romioRN/Dash6.8-hardware/pinout.jpg

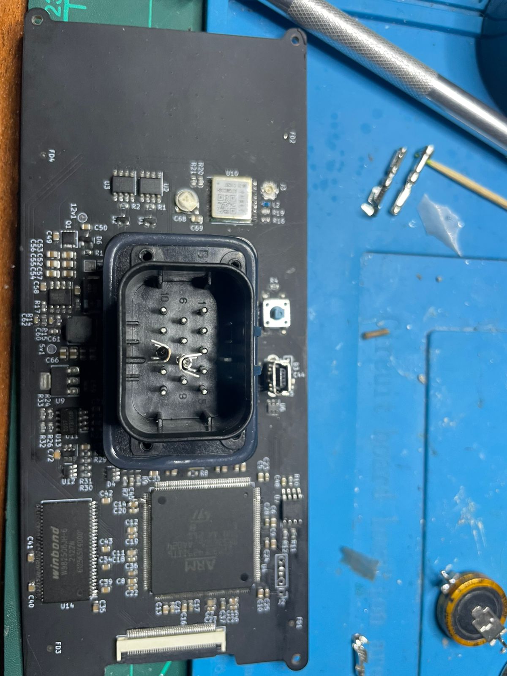
pinout.jpg
