romioRN/Dash6.8-hardware/photos/Dash 6.8.6.jpg

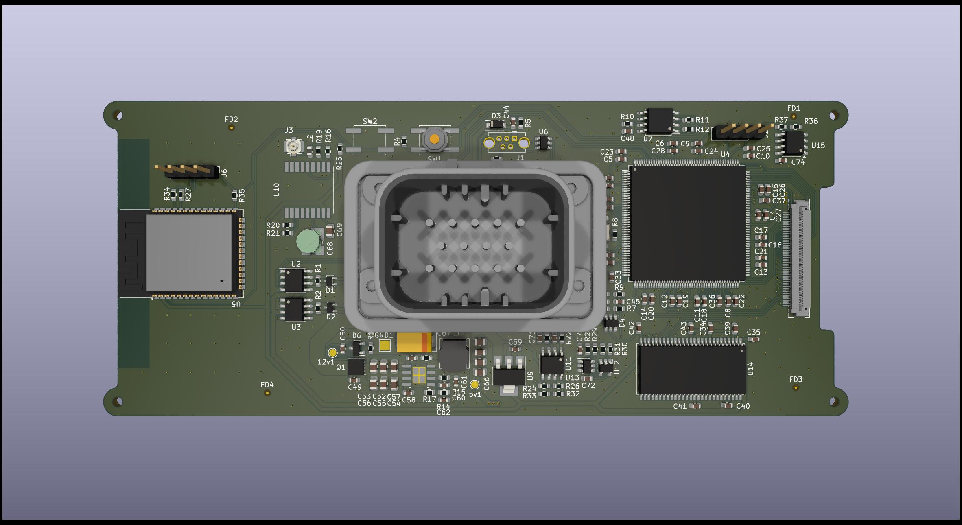
photos/Dash 6.8.6.jpg
