romioRN/Dash6.8-hardware/readme.md

stm32f4

8MB RAM

flash

ESP32 S3 wifi calibration page

ATGM336H GPS with on-board battery

wifi name "service", password 12345678, connect to 192.167.4.1

2 layer PCB

single side assembly

nextPCB

# hardware

* GPS antenna 5v "GPS Antenna SMA Connector Car Mini GPS Receiver Antenna 3 Meters Cable Car GPS Antenna Receiver for Car Navigation Camera Player"

* Пигтейл SMA female - MHF4 адаптер переходник для подключения внешней антенны Best Seller

* ribbon cable FFC FPC 40 pin,Reverse Direction,5cm 0.5mm

* threaded inserts M2xL4xOD3.2

* m2 din912 

# pinout

* pin 6 CANH

* pin 8 GND

* 10 CANL

* pin 12 12v

# Firmware

https://github.com/romioRN/Dash6.8-firmware

precompiled F4 binaries at https://github.com/romioRN/Dash6.8-firmware/tree/main/Firmware/Debug
корпус литье в силикон
корпус литье в силикон 2
