romioRN/Dash6.8-hardware/docs/readme.md

https://www.aliexpress.us/item/3256804554532347.html
перед2
зад2
раз
