romioRN/Dash6.8-hardware/enclosure/enclosure-v1/readme.md

As is, this design would not accept bronze threaded inserts
