romioRN/Dash6.8-hardware/docs/6-86.jpg

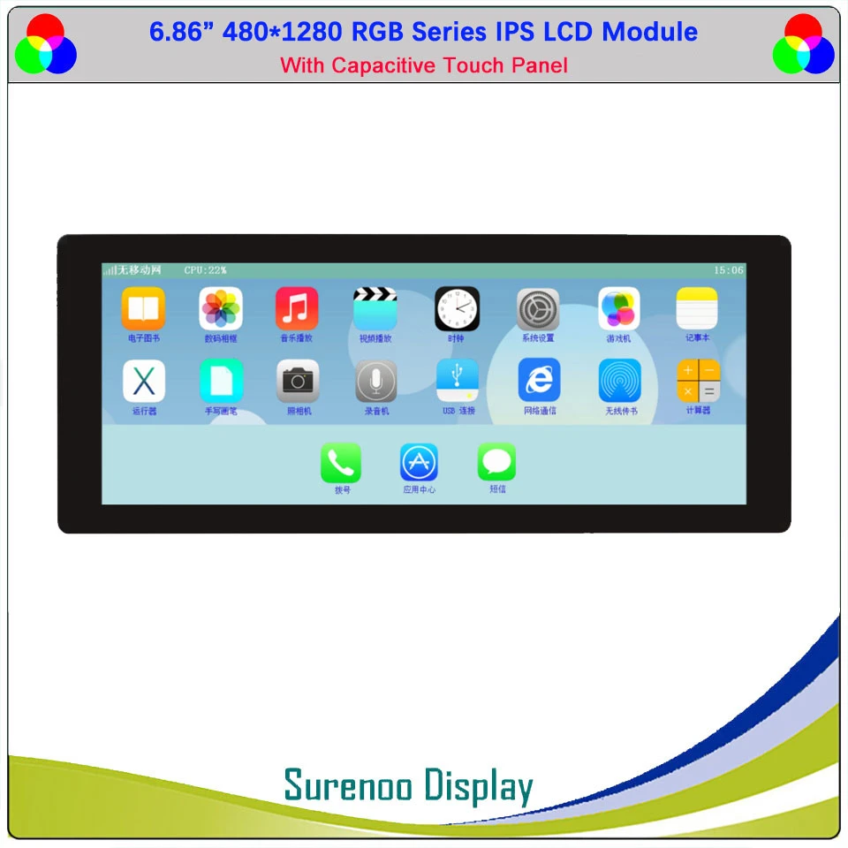
docs/6-86.jpg
