romioRN/Dash6.8-hardware/docs/S1af3b5e822c3414c8dfa9511a9d78017A.jpg

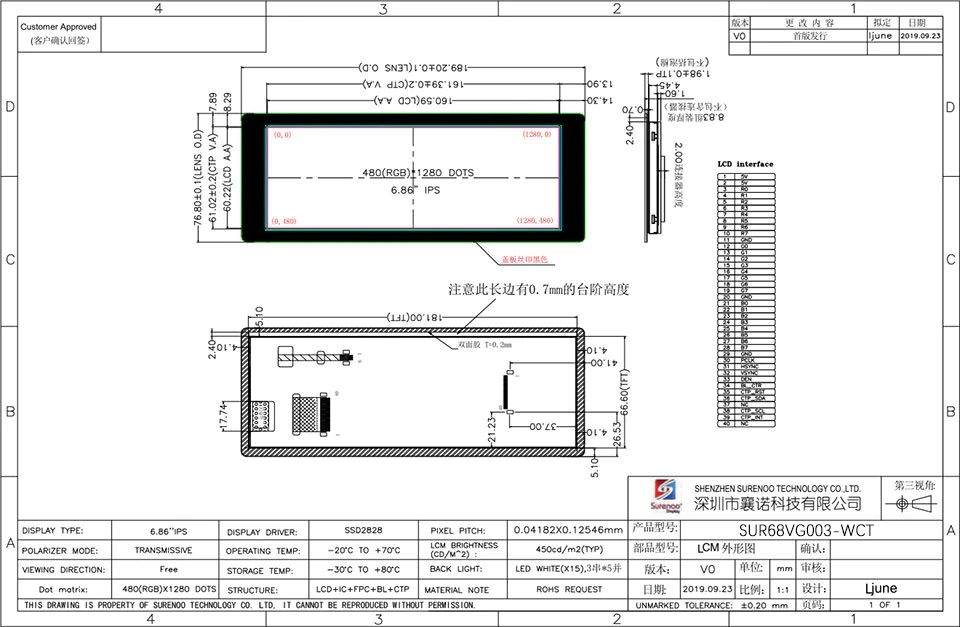
docs/S1af3b5e822c3414c8dfa9511a9d78017A.jpg
