romioRN/Dash6.8-hardware/image/DugaF.png

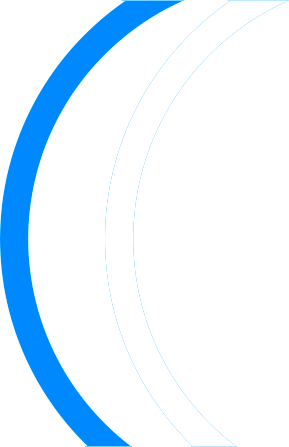
image/DugaF.png
