romioRN/Dash6.8-hardware/image/Fon1.png

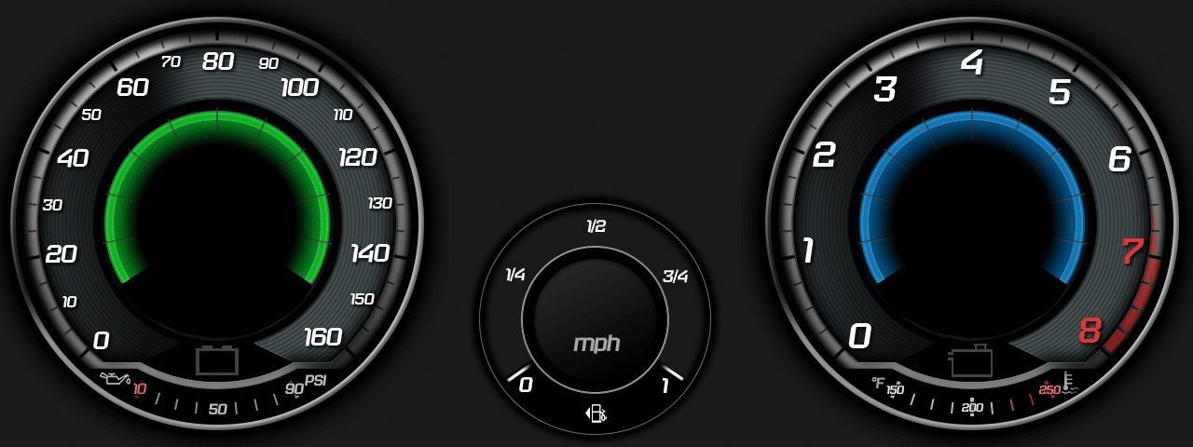
image/Fon1.png
