romioRN/Dash6.8-hardware/image/race_dash_wide.png

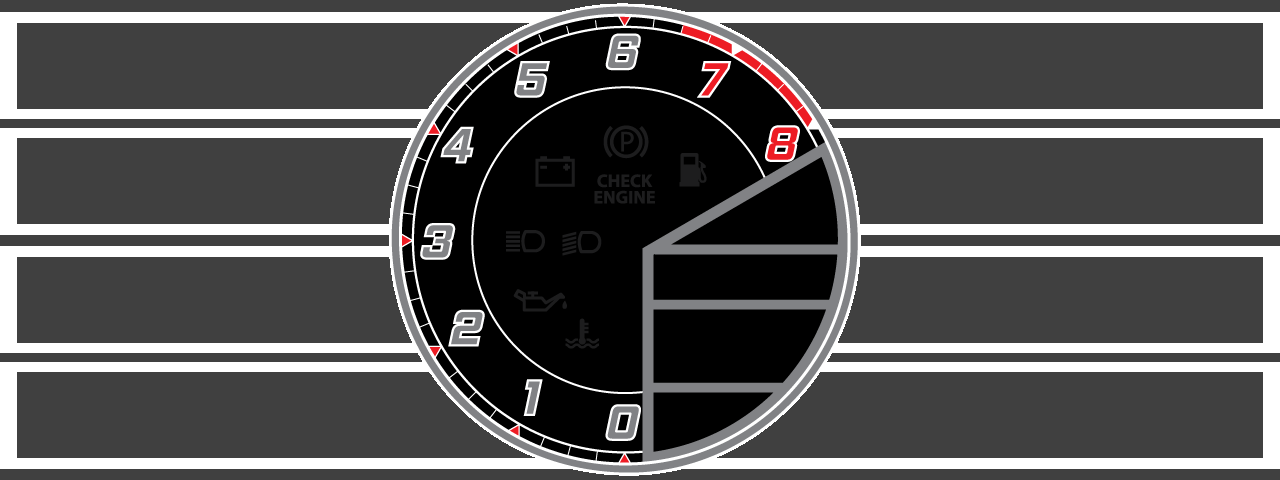
image/race_dash_wide.png
