romioRN/Dash6.8-hardware/image/ST800_2.png

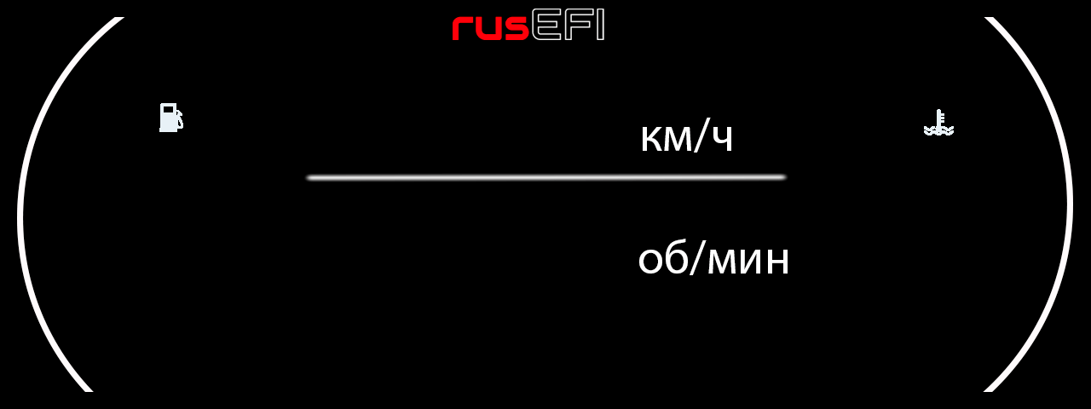
image/ST800_2.png
