romioRN/Dash6.8-hardware/image/ST800_3.png

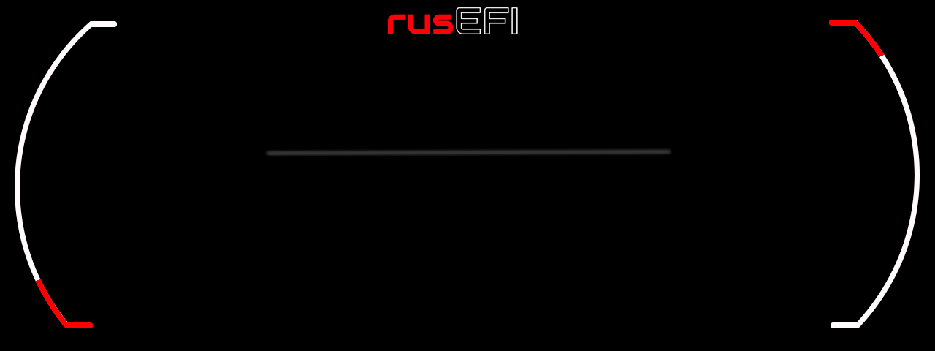
image/ST800_3.png
