romioRN/Dash6.8-hardware/image/ST800_4.png

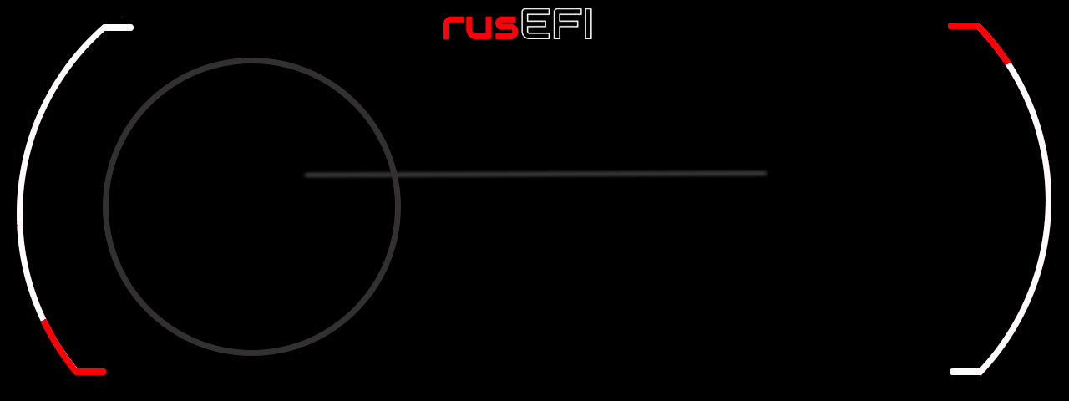
image/ST800_4.png
