romioRN/Dash6.8-hardware/image/ST800_5.png

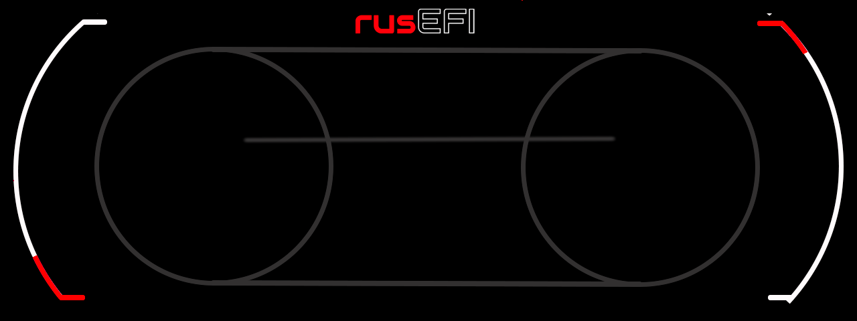
image/ST800_5.png
