romioRN/Dash6.8-hardware/image/ST800_6.png

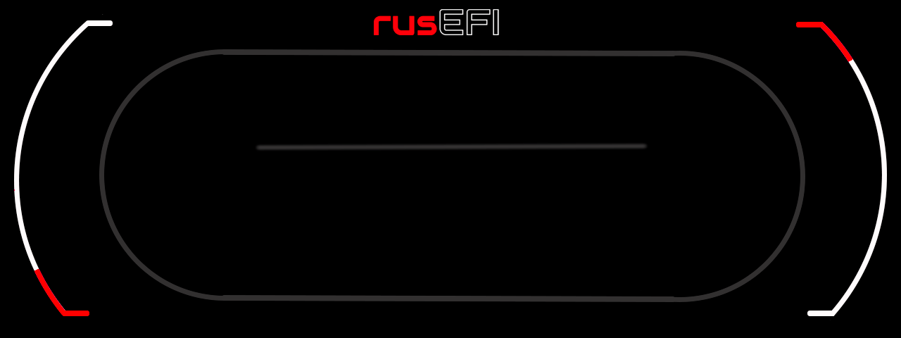
image/ST800_6.png
