romioRN/Dash6.8-hardware/image/ST800_7.png

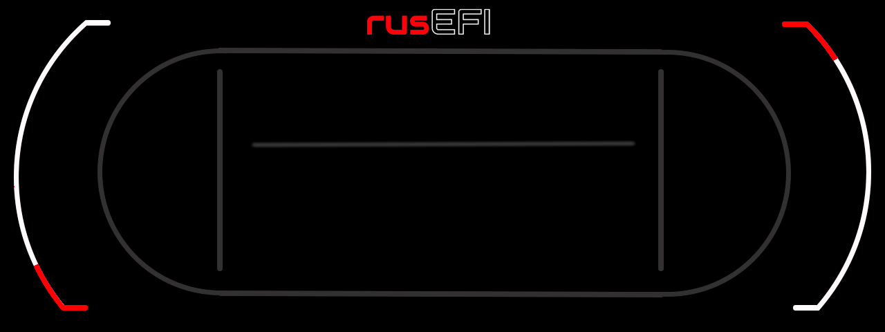
image/ST800_7.png
