romioRN/Dash6.8-hardware/image/ST800_8.png

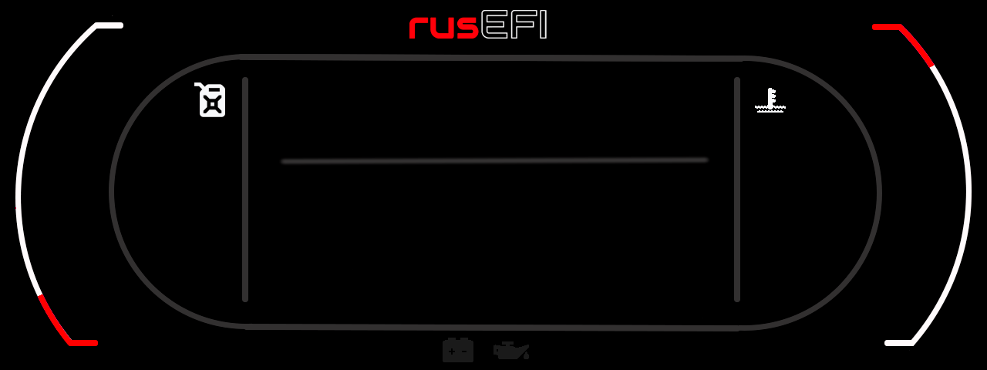
image/ST800_8.png
