romioRN/Dash6.8-hardware/image/приборы стелс800.png

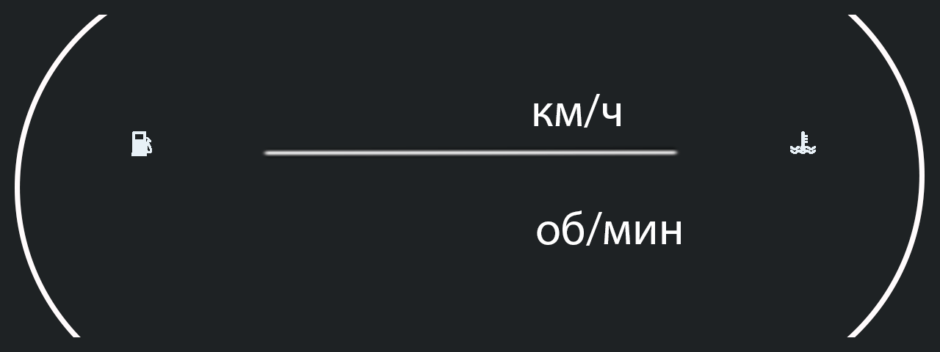
image/приборы стелс800.png
