romioRN/Dash6.8-hardware/image/приборы стелс800_1.png

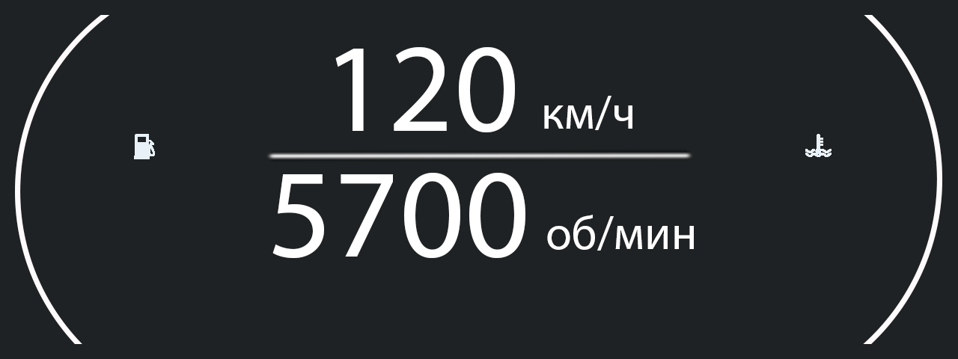
image/приборы стелс800_1.png
