romioRN/Dash6.8-hardware/photos/Dash 6.8.7.jpg

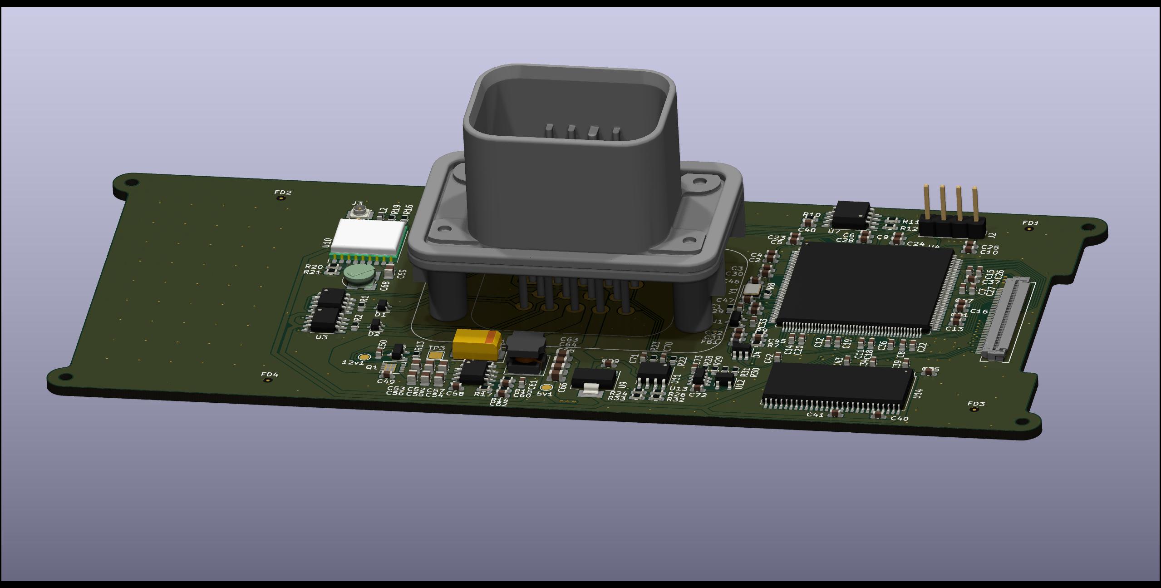
photos/Dash 6.8.7.jpg
