romioRN/Dash6.8-hardware/photos/Dash 6.8.8.jpg

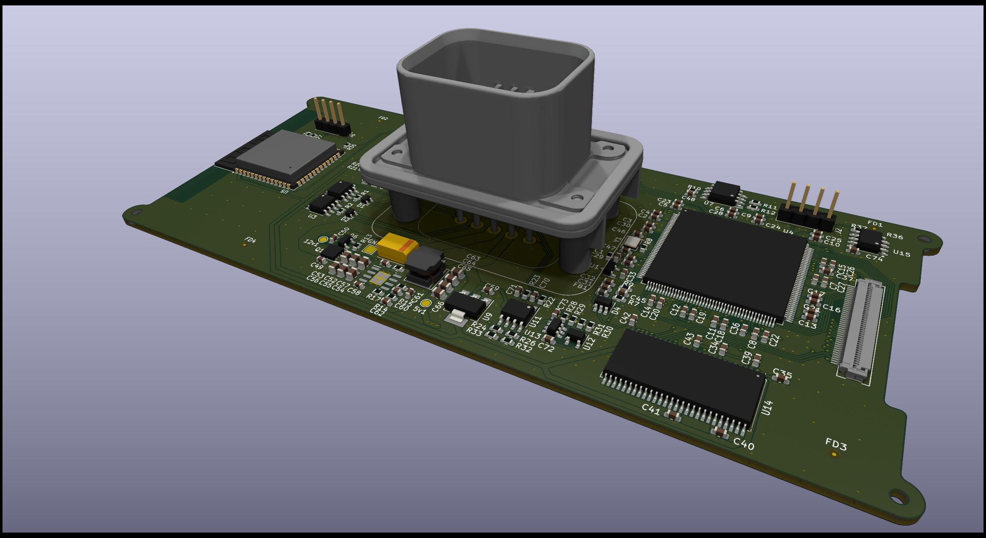
photos/Dash 6.8.8.jpg
