romioRN/Dash6.8-hardware/3d model/silicone casting/Dach_lcd6.89.SLDPRT

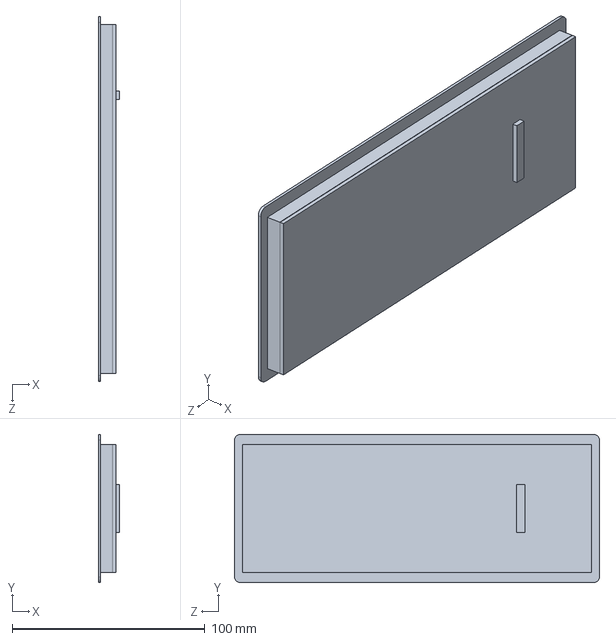
[picture p19: CAD file, 2024-11-07]
3d model/silicone casting/Dach_lcd6.89.SLDPRT
11.0 x 76.8 x 189.2 mm
