romioRN/Dash6.8-hardware/enclosure/enclosure-v1/cover_v1_1.STEP

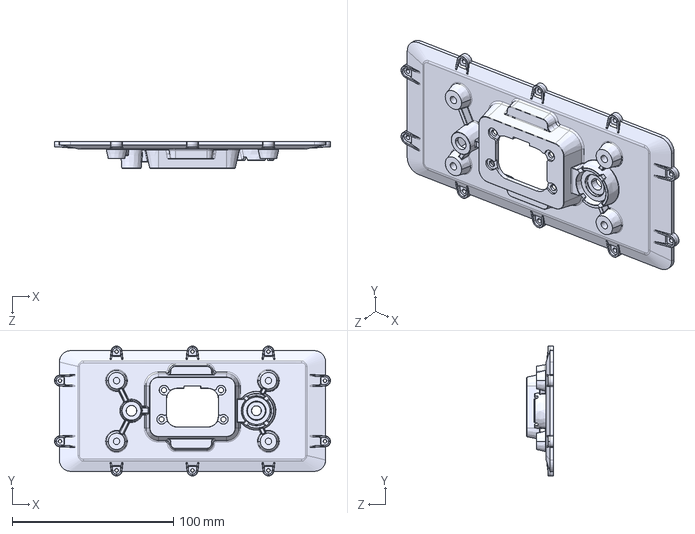
[picture p20: CAD file, 2025-10-01]
enclosure/enclosure-v1/cover_v1_1.STEP
170.9 x 80.4 x 16.5 mm
