romioRN/Dash6.8-hardware/enclosure/enclosure-v1/frame_v1.STEP

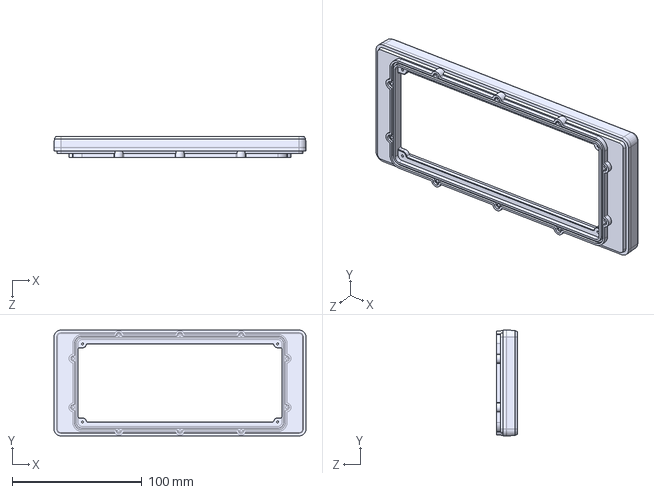
[picture p21: CAD file, 2025-06-23]
enclosure/enclosure-v1/frame_v1.STEP
194.0 x 81.5 x 16.0 mm
