romioRN/Dash6.8-hardware/Dash 6.8_V0.2/776262-1/776262-1.step

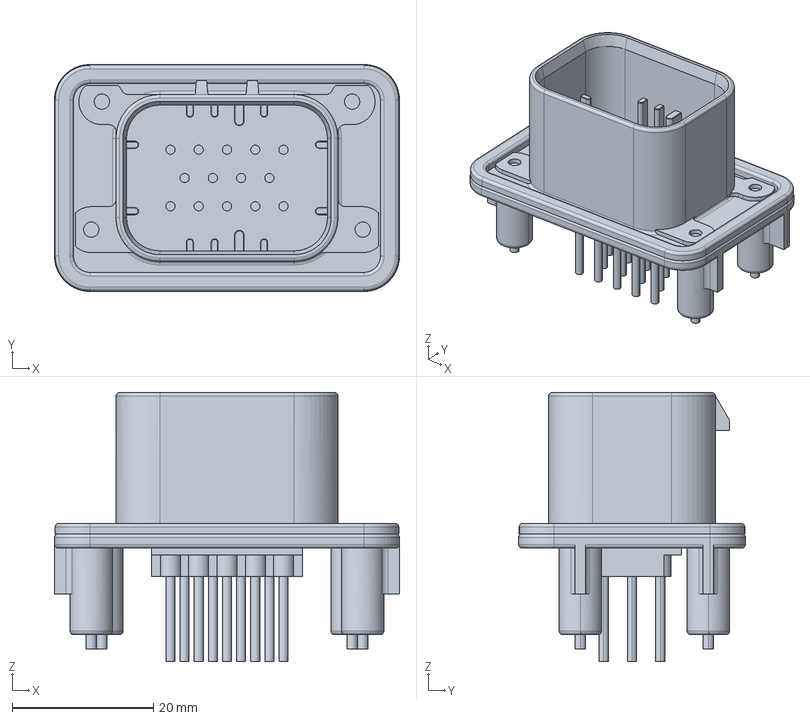
[picture p22: CAD file, 2025-06-23]
Dash 6.8_V0.2/776262-1/776262-1.step
48.8 x 32.1 x 38.1 mm
