romioRN/Dash6.8-hardware/changelog.md

# 0.2

known issue: https://github.com/romioRN/Dash_6.8-hardware/issues/2

still dreaming about H7 - no official H7 configuration

# 0.1

Alive using F429!

Not pin compatible with https://github.com/opelpanfan/car-dash-wide
