romioRN/Dash6.8-hardware/3d model/silicone casting/корпус литье в силикон.pdf

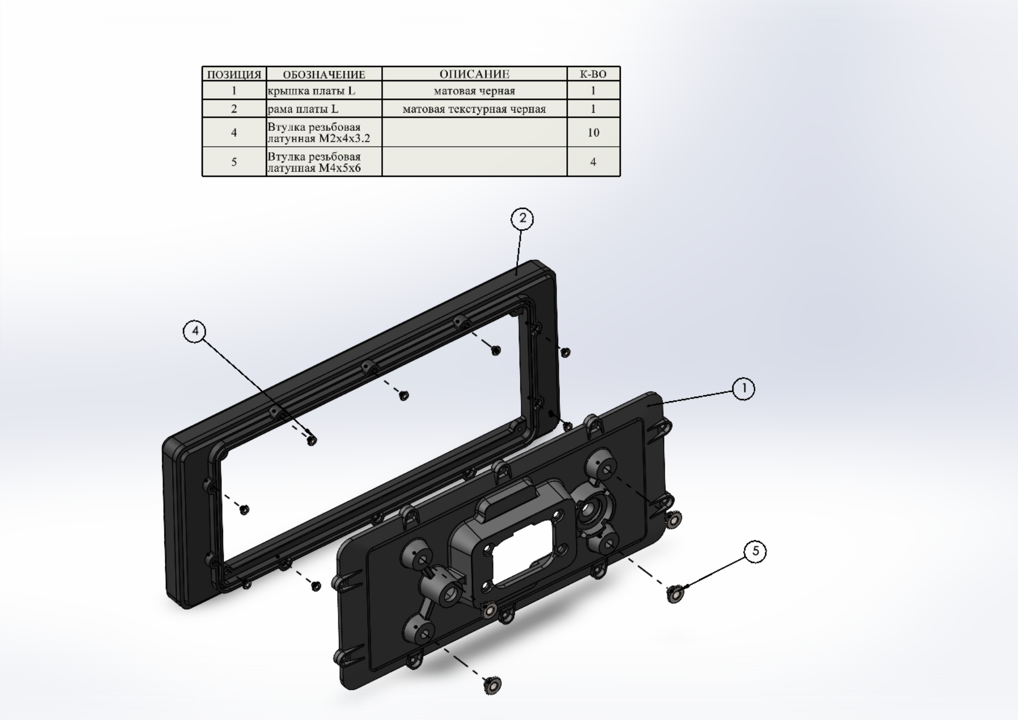
[picture p23: page 1]
