romioRN/Dash6.8-hardware/Dash 6.8_V0.2/Dash 6.8.kicad_pcb

## KiCad design Dash 6.8_V0.2/Dash 6.8.kicad_pcb (2025-09-16)

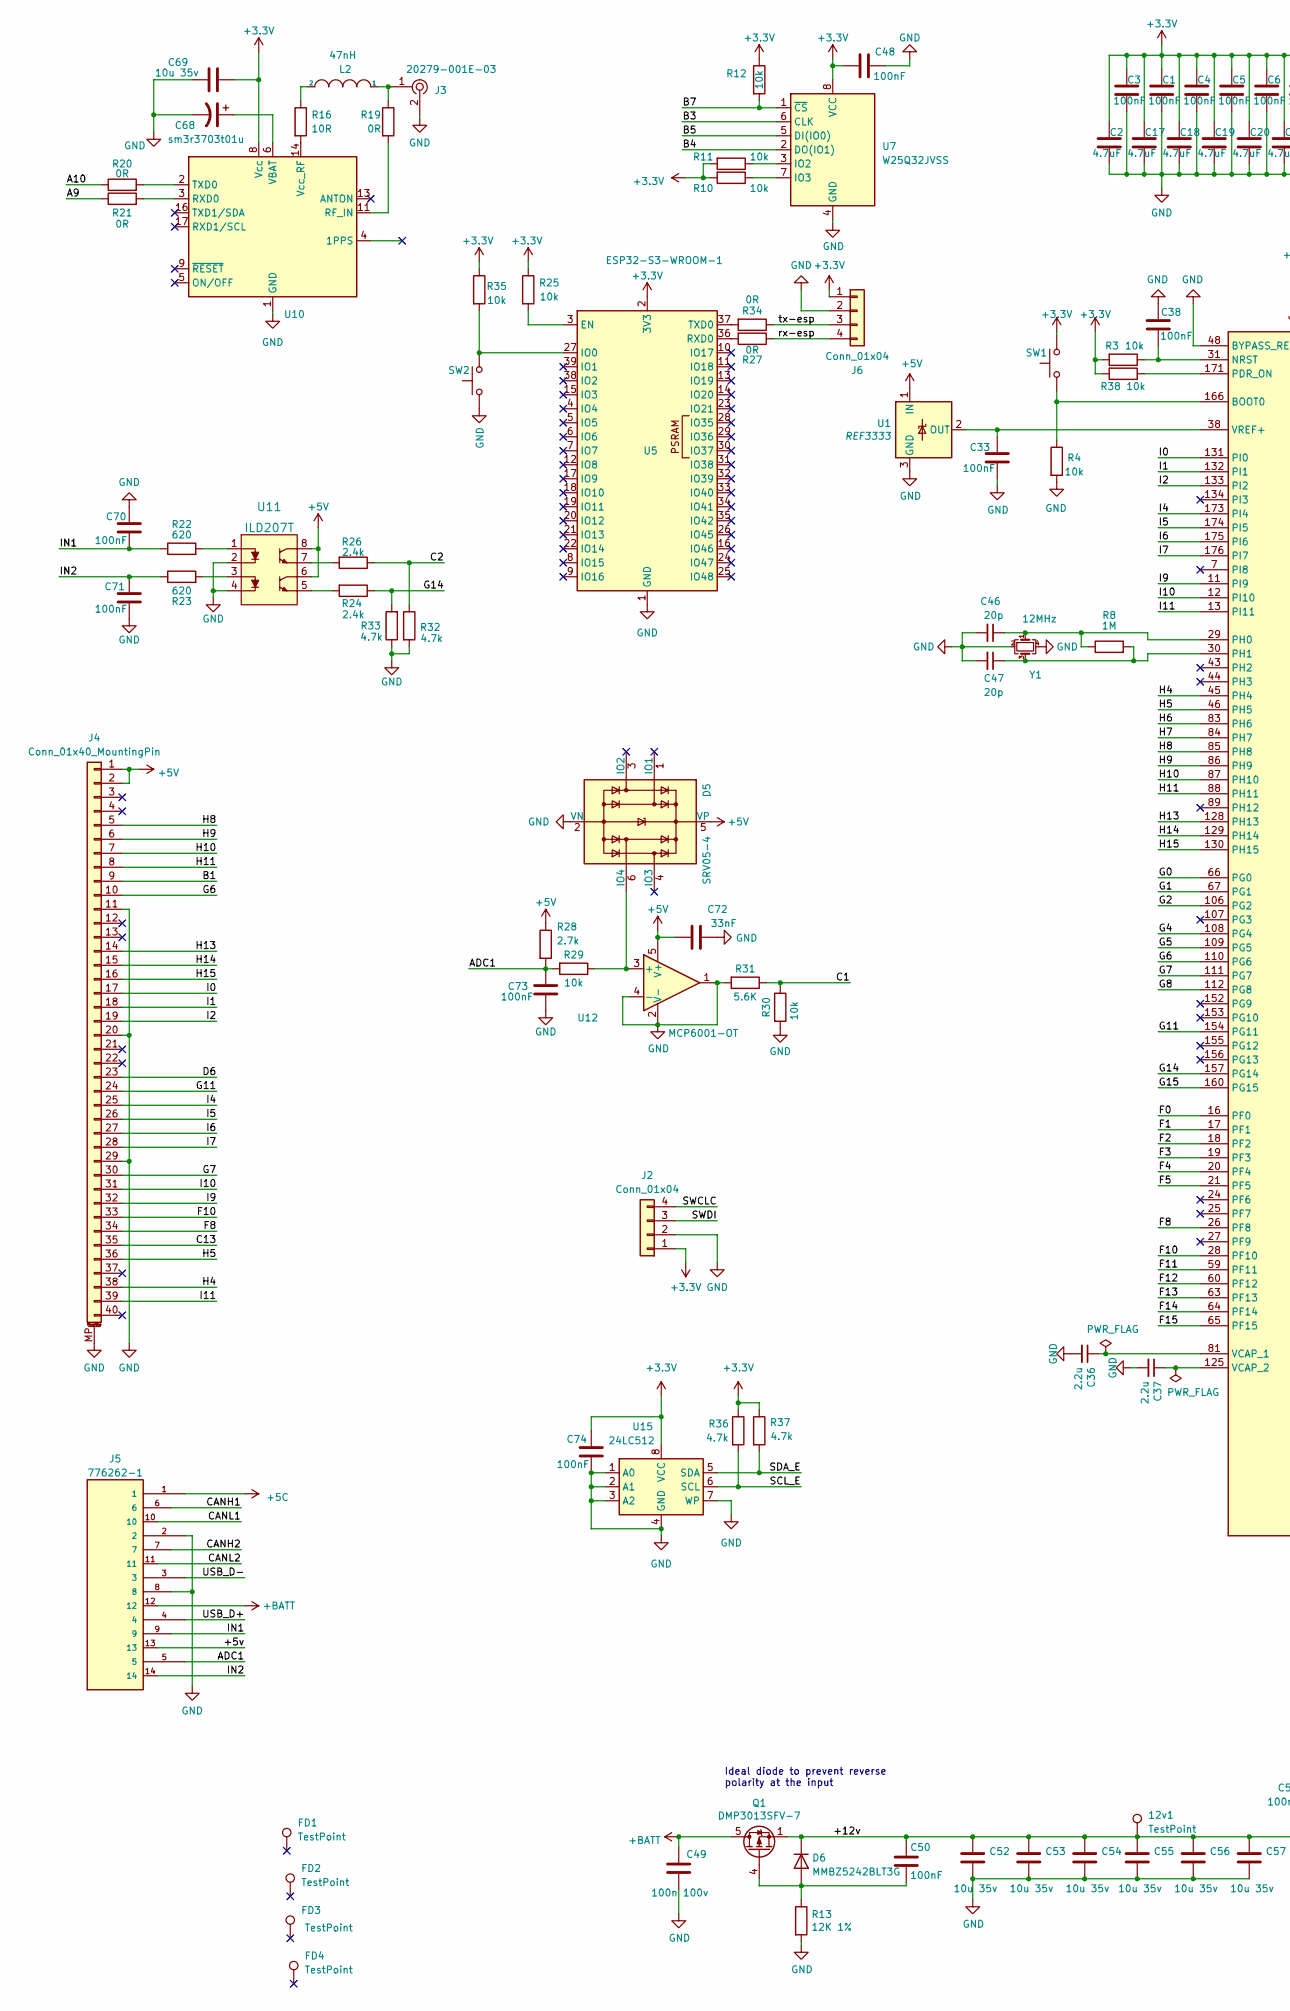
[picture p24: schematic Dash 6.8.kicad_sch, part in row 1, column 1]

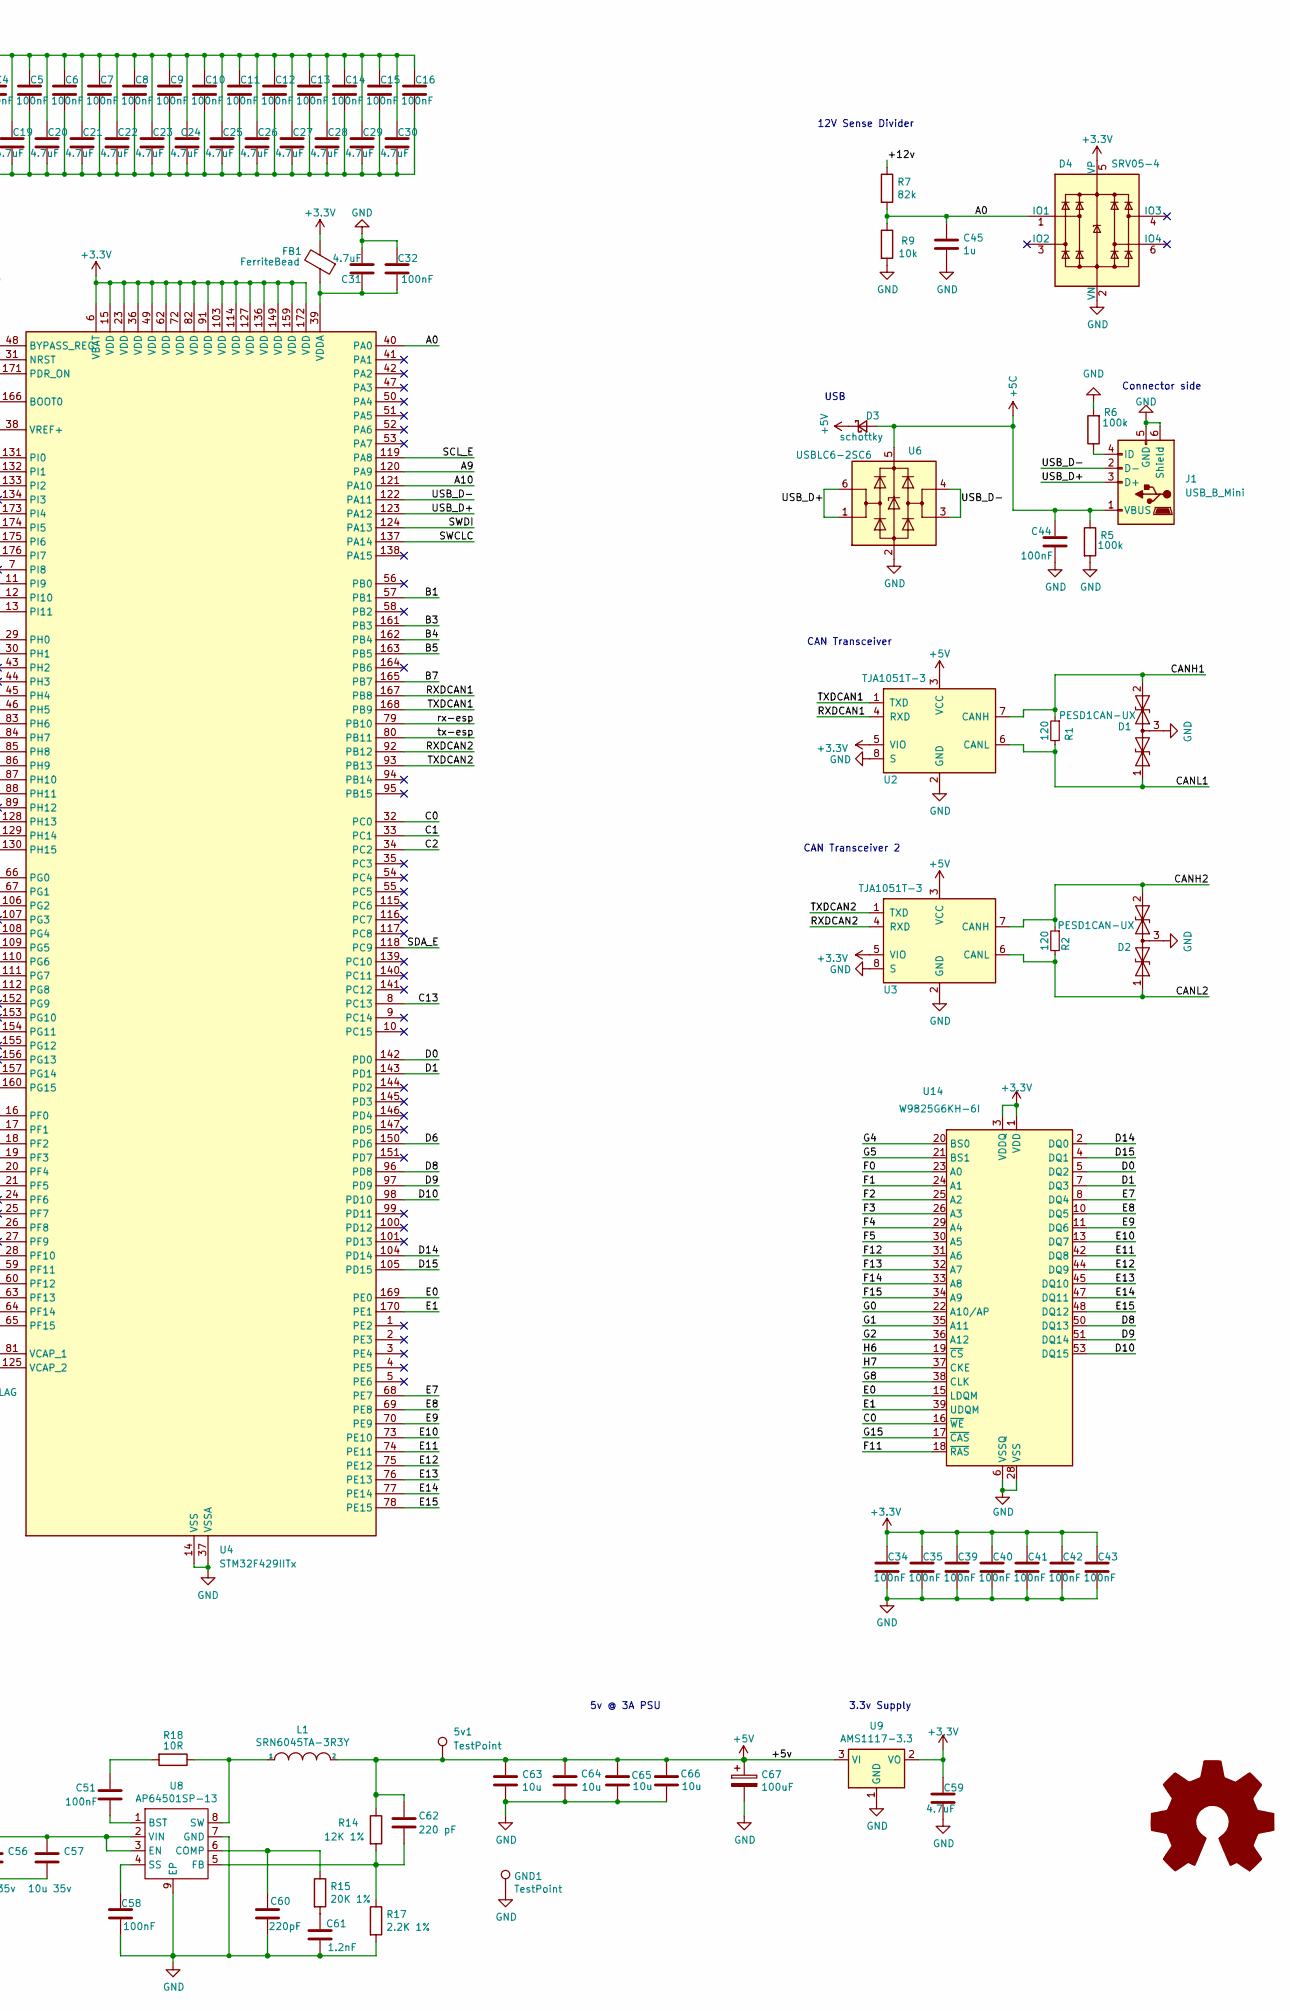
[picture p25: schematic Dash 6.8.kicad_sch, part in row 1, column 2]

Parts:
5v1, 12v1: TestPoint; TestPoint_Pad_D1.5mm
C1, C3, C4, C5, C6, C7, C8, C9, C10, C11, C12, C13, C14, C15, C16, C32, C33, C34, C35, C38, C39, C40, C41, C42, C43, C44, C48, C50, C51, C58, C70, C71, C73, C74: 100nF; C_0603_1608Metric; Part CC0603KRX7R9BB104
C2, C17, C18, C19, C20, C21, C22, C23, C24, C25, C26, C27, C28, C29, C30, C31, C59: 4.7uF; C_0603_1608Metric; Part CL10A475KO8NNNC
C36, C37: 2.2u; C_0603_1608Metric; Part CL10A225KO8NNNC; LCSC C23630
C45: 1u; C_0603_1608Metric; Part CL10A105KB8NNNC; LCSC C15849
C46, C47: 20p; C_0603_1608Metric; Part GRM1885C1H200JA01D
C49: 100n 100v; C_0603_1608Metric; Part CC0603KRX7R0BB104
C52, C53, C54, C55, C56, C57, C69: 10u 35v; C_0805_2012Metric; Part GRM21BC8YA106KE11L
C60: 220pF; C_0603_1608Metric; Part CC0603KRX7R0BB221
C61: 1.2nF; C_0603_1608Metric; Part CC0603KRX7R9BB122
C62: 220 pF; C_0603_1608Metric; Part CC0603KRX7R0BB221
C63, C64, C65, C66: 10u; C_0805_2012Metric; Part GRM21BR71A106KA73L
C67: 100uF; CP_EIA-7343-31_Kemet-D; Part 667-EEF-CX0J101R
C68: sm3r3703t01u; SM3R3703T01U; Part sm3r3703t01u
C72: 33nF; C_0603_1608Metric; Part CL10B333KB8NNNC
D1, D2: PESD1CAN-UX; SOT-323_SC-70; Part PESD1CAN-UX; LCSC C152727
D3: schottky; D_SOD-123; Part B5819W SL; LCSC C8598
D4, D5: SRV05-4; SOT-23-6; Part SRV05-4-P-T7; LCSC C85364
D6: MMBZ5242BLT3G; SOT-23; Part MMBZ5242BLT3G
FB1: FerriteBead; L_0603_1608Metric; Part BLM18PG471SN1D
FD1, FD2, FD3, FD4: TestPoint; Fiducial_0.5mm_Mask1.5mm
GND1: TestPoint; TestPoint_Pad_2.0x2.0mm
J1: USB_B_Mini; USB_Mini-B_Tensility_54-00023_Vertical_CircularHoles; Part 920-462A2021Y10101
J2, J6: Conn_01x04; PinHeader_1x04_P2.54mm_Vertical
J3: 20279-001E-03; U.FL_Molex_MCRF_73412-0110_Vertical; Part 20279-001E-03
J4: Conn_01x40_MountingPin; F-FPC0M40P-C310; Part F-FPC0M40P-C310
J5: 776262-1; TE_776262-1; PARTREV A8
L1: SRN6045TA-3R3Y; L_Bourns_SRN6045TA; Part SRN6045TA-3R3Y
L2: 47nH; L_0603_1608Metric; Part LQW18AN47NG00D
Q1: DMP3013SFV-7; Diodes_PowerDI3333-8; Part DMP3013SFV-7
R1, R2: 120; R_0603_1608Metric; Part RC0603JR-07120RL; LCSC C22787
R3, R4, R9, R10, R11, R12, R25, R29, R30, R35, R38: 10k; R_0603_1608Metric; Part CRCW060310K0FKEAC
R5, R6: 100k; R_0603_1608Metric; Part RC0603FR-07100KL; LCSC_ext 0
R7: 82k; R_0603_1608Metric; Part RC0603JR-0782KL; LCSC_ext 0
R8: 1M; R_0603_1608Metric; Part RT0603BRD071ML
R13, R14: 12K 1%; R_0603_1608Metric; Part RC0603FR-0712KL
R15: 20K 1%; R_0603_1608Metric; Part RC0603FR-0720KL
R16, R18: 10R; R_0603_1608Metric; Part CRCW060310R0FKEA
R17: 2.2K 1%; R_0603_1608Metric; Part RC0603FR-072K2L
R19, R20, R21, R27, R34: 0R; R_0603_1608Metric; Part RC0603JR-070RL
R22, R23: 620; R_0603_1608Metric; Part RC0603JR-07620RL
R24, R26: 2.4k; R_0603_1608Metric; Part RC0603FR-072K4L
R28: 2.7k; R_0603_1608Metric; Part RC0603JR-072K7L
R31: 5.6K; R_0603_1608Metric; Part RT0603BRD075K62L
R32, R33, R36, R37: 4.7k; R_0603_1608Metric; Part RT0603BRD074K7L
SW1, SW2: SW_Push; SW_SPST_EVQQ2; Part TS-1187A-C-E-B; LCSC C318887
U1: REF3333; SOT-23; Part REF3333AIDBZR; LCSC C130016
U2, U3: TJA1051T-3; SOIC-8_3.9x4.9mm_P1.27mm; Part TJA1051T/3/1J; LCSC C38695
U4: STM32F429IITx; LQFP-176_24x24mm_P0.5mm; Part STM32F429IIT6
U5: ESP32-S3-WROOM-1; Part ESP32-S3-WROOM-1-N16R8
U6: USBLC6-2SC6; SOT-23-6; Part USBLC6-2; LCSC C7519
U7: W25Q32JVSS; SOIC-8_5.23x5.23mm_P1.27mm; Part W25Q32JVSSIQ
U8: AP64501SP-13; SOIC-8-1EP_3.9x4.9mm_P1.27mm_EP2.95x4.9mm_Mask2.71x3.4mm_Th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; Part AP64501SP-13
U9: AMS1117-3.3; SOT-223-3_TabPin2; Part AMS1117-3.3; LCSC_ext 0
U10: SIM28ML; Part atgm336h-5n71
U11: ILD207T; SOIC-8_3.9x4.9mm_P1.27mm; Part ILD207T; Digi-Key_PN 751-1310-1-ND
U12: MCP6001-OT; SOT-23-5; Part MCP6001T-I/OT
U14: W9825G6KH-6I; TSOP-II-54_22.2x10.16mm_P0.8mm; Part W9825G6KH-6I
U15: 24LC512; SOIC-8_3.9x4.9mm_P1.27mm; Part M24512-RMN6TP
Y1: 12MHz; Crystal_SMD_3225-4Pin_3.2x2.5mm; Part X322512MOB4SI

Connections:
+3.3V: C1.1, C2.1, C3.1, C4.1, C5.1, C6.1, C7.1, C8.1, C9.1, C10.1, C11.1, C12.1, C13.1, C14.1, C15.1, C16.1, C17.1, C18.1, C19.1, C20.1, C21.1, C22.1, C23.1, C24.1, C25.1, C26.1, C27.1, C28.1, C29.1, C30.1, C34.1, C35.1, C39.1, C40.1, C41.1, C42.1, C43.1, C48.1, C59.1, C69.2, C74.1, D4.5 (VP), FB1.2, J2.1, J6.1, R3.2, R10.2, R11.2, R12.1, R25.1, R35.1, R36.1, R37.1, R38.2, SW1.2, U2.5 (VIO), U3.5 (VIO), U4.6 (VBAT), U4.15 (VDD), U4.23 (VDD), U4.36 (VDD), U4.49 (VDD), U4.62 (VDD), U4.72 (VDD), U4.82 (VDD), U4.91 (VDD), U4.103 (VDD), U4.114 (VDD), U4.127 (VDD), U4.136 (VDD), U4.149 (VDD), U4.159 (VDD), U4.172 (VDD), U5.2 (3V3), U7.8 (VCC), U9.2 (VO), U10.8 (Vcc), U14.1 (VDD), U14.3 (VDDQ), U14.9 (VDDQ), U14.14 (VDD), U14.27 (VDD), U14.43 (VDDQ), U14.49 (VDDQ), U15.8 (VCC)
+5C: C44.1, D3.2 (A), J1.1 (VBUS), J5.1, R5.1, U6.5 (VBUS)
+5V: 5v1.1, C62.1, C63.1, C64.1, C65.1, C66.1, C67.1, C72.2, D3.1 (K), D5.5 (VP), J4.1, J4.2, J5.13, L1.2, R14.1, R28.1, U1.1 (IN), U2.3 (VCC), U3.3 (VCC), U9.3 (VI), U11.6, U11.8, U12.5 (V+)
+BATT: C49.1, J5.12, Q1.5 (D)
/+12v: 12v1.1, C50.1, C52.1, C53.1, C54.1, C55.1, C56.1, C57.1, D6.3 (K), Q1.1 (S), Q1.2 (S), Q1.3 (S), R7.1, U8.2 (VIN), U8.3 (EN)
/A0: C45.1, D4.1 (IO1), R7.2, R9.1, U4.40 (PA0)
/A9: R21.1, U4.120 (PA9)
/A10: R20.1, U4.121 (PA10)
/ADC1: C73.1, J5.5, R28.2, R29.2
/B1: J4.9, U4.57 (PB1)
/B3: U4.161 (PB3), U7.6 (CLK)
/B4: U4.162 (PB4), U7.2 (DO(IO1))
/B5: U4.163 (PB5), U7.5 (DI(IO0))
/B7: R12.2, U4.165 (PB7), U7.1 (~CS)
/C0: U4.32 (PC0), U14.16 (~WE)
/C1: R30.1, R31.1, U4.33 (PC1)
/C2: R26.1, R32.1, U4.34 (PC2)
/C13: J4.35, U4.8 (PC13)
/CANH1: D1.2 (A2), J5.6, R1.1, U2.7 (CANH)
/CANH2: D2.2 (A2), J5.7, R2.1, U3.7 (CANH)
/CANL1: D1.1 (A1), J5.10, R1.2, U2.6 (CANL)
/CANL2: D2.1 (A1), J5.11, R2.2, U3.6 (CANL)
/D0: U4.142 (PD0), U14.5 (DQ2)
/D1: U4.143 (PD1), U14.7 (DQ3)
/D6: J4.23, U4.150 (PD6)
/D8: U4.96 (PD8), U14.50 (DQ13)
/D9: U4.97 (PD9), U14.51 (DQ14)
/D10: U4.98 (PD10), U14.53 (DQ15)
/D14: U4.104 (PD14), U14.2 (DQ0)
/D15: U4.105 (PD15), U14.4 (DQ1)
/E0: U4.169 (PE0), U14.15 (LDQM)
/E1: U4.170 (PE1), U14.39 (UDQM)
/E7: U4.68 (PE7), U14.8 (DQ4)
/E8: U4.69 (PE8), U14.10 (DQ5)
/E9: U4.70 (PE9), U14.11 (DQ6)
/E10: U4.73 (PE10), U14.13 (DQ7)
/E11: U4.74 (PE11), U14.42 (DQ8)
/E12: U4.75 (PE12), U14.44 (DQ9)
/E13: U4.76 (PE13), U14.45 (DQ10)
/E14: U4.77 (PE14), U14.47 (DQ11)
/E15: U4.78 (PE15), U14.48 (DQ12)
/F0: U4.16 (PF0), U14.23 (A0)
/F1: U4.17 (PF1), U14.24 (A1)
/F2: U4.18 (PF2), U14.25 (A2)
/F3: U4.19 (PF3), U14.26 (A3)
/F4: U4.20 (PF4), U14.29 (A4)
/F5: U4.21 (PF5), U14.30 (A5)
/F8: J4.34, U4.26 (PF8)
/F10: J4.33, U4.28 (PF10)
/F11: U4.59 (PF11), U14.18 (~RAS)
/F12: U4.60 (PF12), U14.31 (A6)
/F13: U4.63 (PF13), U14.32 (A7)
/F14: U4.64 (PF14), U14.33 (A8)
/F15: U4.65 (PF15), U14.34 (A9)
/G0: U4.66 (PG0), U14.22 (A10/AP)
/G1: U4.67 (PG1), U14.35 (A11)
/G2: U4.106 (PG2), U14.36 (A12)
/G4: U4.108 (PG4), U14.20 (BS0)
/G5: U4.109 (PG5), U14.21 (BS1)
/G6: J4.10, U4.110 (PG6)
/G7: J4.30, U4.111 (PG7)
/G8: U4.112 (PG8), U14.38 (CLK)
/G11: J4.24, U4.154 (PG11)
/G14: R24.1, R33.2, U4.157 (PG14)
/G15: U4.160 (PG15), U14.17 (~CAS)
/H4: J4.38, U4.45 (PH4)
/H5: J4.36, U4.46 (PH5)
/H6: U4.83 (PH6), U14.19 (~CS)
/H7: U4.84 (PH7), U14.37 (CKE)
/H8: J4.5, U4.85 (PH8)
/H9: J4.6, U4.86 (PH9)
/H10: J4.7, U4.87 (PH10)
/H11: J4.8, U4.88 (PH11)
/H13: J4.14, U4.128 (PH13)
/H14: J4.15, U4.129 (PH14)
/H15: J4.16, U4.130 (PH15)
/I0: J4.17, U4.131 (PI0)
/I1: J4.18, U4.132 (PI1)
/I2: J4.19, U4.133 (PI2)
/I4: J4.25, U4.173 (PI4)
/I5: J4.26, U4.174 (PI5)
/I6: J4.27, U4.175 (PI6)
/I7: J4.28, U4.176 (PI7)
/I9: J4.32, U4.11 (PI9)
/I10: J4.31, U4.12 (PI10)
/I11: J4.39, U4.13 (PI11)
/IN1: C70.2, J5.9, R22.1
/IN2: C71.1, J5.14, R23.1
/RXDCAN1: U2.4 (RXD), U4.167 (PB8)
/RXDCAN2: U3.4 (RXD), U4.92 (PB12)
/SCL_E: R36.2, U4.119 (PA8), U15.6 (SCL)
/SDA_E: R37.2, U4.118 (PC9), U15.5 (SDA)
/SWCLC: J2.4, U4.137 (PA14)
/SWDI: J2.3, U4.124 (PA13)
/TXDCAN1: U2.1 (TXD), U4.168 (PB9)
/TXDCAN2: U3.1 (TXD), U4.93 (PB13)
/USB_D+: J1.3 (D+), J5.4, U4.123 (PA12), U6.1 (I/O1), U6.6 (I/O1)
/USB_D-: J1.2 (D-), J5.3, U4.122 (PA11), U6.3 (I/O2), U6.4 (I/O2)
/rx-esp: J6.4, R27.1, U4.79 (PB10)
/tx-esp: J6.3, R34.1, U4.80 (PB11)
GND: C1.2, C2.2, C3.2, C4.2, C5.2, C6.2, C7.2, C8.2, C9.2, C10.2, C11.2, C12.2, C13.2, C14.2, C15.2, C16.2, C17.2, C18.2, C19.2, C20.2, C21.2, C22.2, C23.2, C24.2, C25.2, C26.2, C27.2, C28.2, C29.2, C30.2, C31.2, C32.1, C33.2, C34.2, C35.2, C36.2, C37.2, C38.1, C39.2, C40.2, C41.2, C42.2, C43.2, C44.2, C45.2, C46.2, C47.2, C48.2, C49.2, C52.2, C53.2, C54.2, C55.2, C56.2, C57.2, C58.2, C59.2, C60.2, C61.2, C63.2, C64.2, C65.2, C66.2, C67.2, C68.2, C69.1, C70.1, C71.2, C72.1, C73.2, C74.2, D1.3 (common), D2.3 (common), D4.2 (VN), D5.2 (VN), GND1.1, J1.5 (GND), J1.6 (Shield), J2.2, J3.2, J4.11, J4.20, J4.29, J4.MP (MountPin), J5.2, J5.8, J6.2, R4.2, R5.2, R6.2, R9.2, R13.2, R17.2, R30.2, R31.2, R32.2, R33.1, SW2.1, U1.3 (GND), U2.2 (GND), U2.8 (S), U3.2 (GND), U3.8 (S), U4.14 (VSS), U4.22 (VSS), U4.37 (VSSA), U4.48 (BYPASS_REG), U4.61 (VSS), U4.71 (VSS), U4.90 (VSS), U4.102 (VSS), U4.113 (VSS), U4.126 (VSS), U4.135 (VSS), U4.148 (VSS), U4.158 (VSS), U5.1 (GND), U5.40 (GND), U5.41 (GND), U6.2 (GND), U7.4 (GND), U8.7 (GND), U8.9 (EP), U9.1 (GND), U10.1 (GND), U10.10 (GND), U10.12 (GND), U11.2, U11.4, U12.1, U12.2 (V-), U12.4 (-), U14.6 (VSSQ), U14.12 (VSSQ), U14.28 (VSS), U14.41 (VSS), U14.46 (VSSQ), U14.52 (VSSQ), U14.54 (VSS), U15.1 (A0), U15.2 (A1), U15.3 (A2), U15.4 (GND), U15.7 (WP), Y1.2, Y1.4
unnamed: C51.1, R18.2
unnamed: C61.1, R15.2
unnamed: D5.6 (IO4), R29.1, U12.3 (+)
unnamed: C50.2, D6.1 (A), Q1.4 (G), R13.1
unnamed: J1.4 (ID), R6.1
unnamed: J3.1, L2.1, R19.1
unnamed: L2.2, R16.1
unnamed: R22.2, U11.1
unnamed: R23.2, U11.3
unnamed: R24.2, U11.5
unnamed: R26.2, U11.7
unnamed: C33.1, U1.2 (OUT), U4.38 (VREF+)
unnamed: R4.1, SW1.1, U4.166 (BOOT0)
unnamed: C38.2, R3.1, U4.31 (NRST)
unnamed: R38.1, U4.171 (PDR_ON)
unnamed: C46.1, R8.1, U4.29 (PH0), Y1.1
unnamed: C47.1, R8.2, U4.30 (PH1), Y1.3
unnamed: C36.1, U4.81 (VCAP_1)
unnamed: C37.1, U4.125 (VCAP_2)
unnamed: C31.1, C32.2, FB1.1, U4.39 (VDDA)
unnamed: R25.2, U5.3 (EN)
unnamed: R35.2, SW2.2, U5.27 (IO0)
unnamed: R27.2, U5.36 (RXD0)
unnamed: R34.2, U5.37 (TXD0)
unnamed: R11.1, U7.3 (IO2)
unnamed: R10.1, U7.7 (IO3)
unnamed: C51.2, U8.1 (BST)
unnamed: C60.1, R15.1, U8.6 (COMP)
unnamed: C62.2, R14.2, R17.1, U8.5 (FB)
unnamed: C58.1, U8.4 (SS)
unnamed: L1.1, R18.1, U8.8 (SW)
unnamed: R19.2, U10.11 (RF_IN)
unnamed: R21.2, U10.3 (RXD0)
unnamed: R20.2, U10.2 (TXD0)
unnamed: C68.1, U10.6 (VBAT)
unnamed: R16.2, U10.14 (Vcc_RF)

Notes on the sheet:
Ideal diode to prevent reverse polarity at the input
USB
3.3v Supply
12V Sense Divider
CAN Transceiver 2
5v @ 3A PSU
Connector side
CAN Transceiver

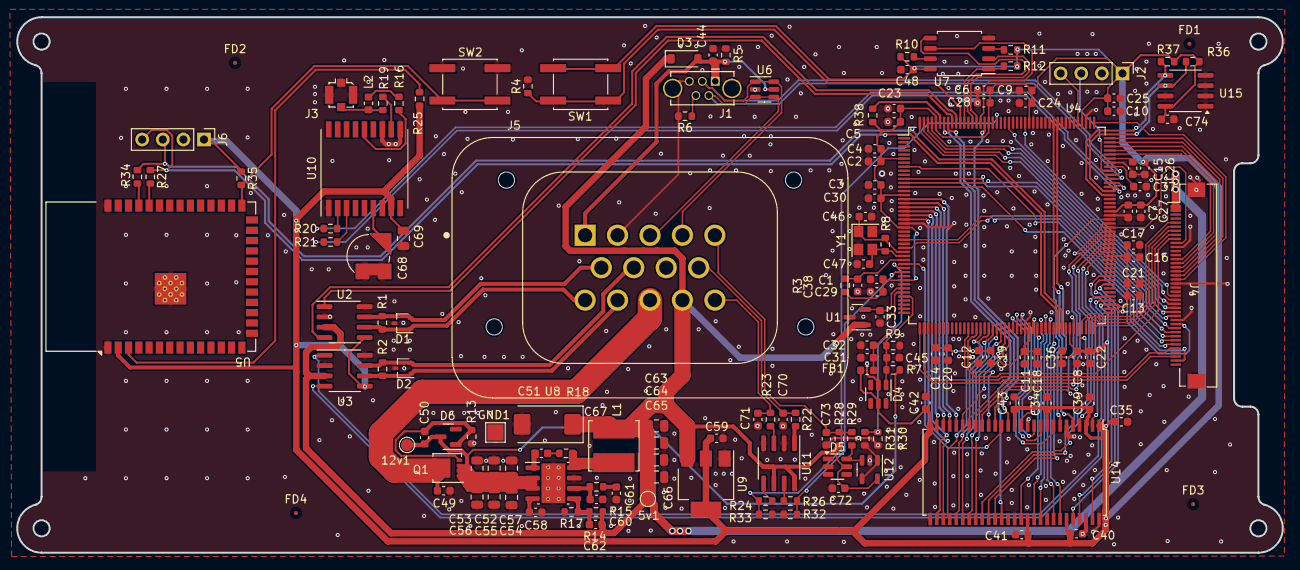
[picture p26: board Dash 6.8.kicad_pcb from above]

Board: 2 copper layers, 156.0 x 66.0 mm, 152 parts (0 on the bottom side), 137 nets.
