romioRN/Dash6.8-hardware/(commit log)

2025-05-22 добовление ESP32 обновлен корпус
    [Dach_lcd6.89.SLDPRT]
2025-06-23 новая версия платы
    [776262-1.step, BOOM.xlsx, Boom_Dash_6.8_429.csv, Boom_Dash_6.8_429.xlsx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]
2025-08-10 рама платы
2025-08-21 typo BOM not boom
    [BOM.xlsx, Bom_Dash_6.8_429.csv, Bom_Dash_6.8_429.xlsx]
2025-08-21 enclosure files
    [frame.STEP]
2025-09-16 уброно лишнее исправлены название паопк
    [крышка платы L1.SLDPRT]
2025-09-16 исправление платы V01
    [Dash 6.8.kicad_pcb, Dash 6.8.kicad_sch]
2025-09-16 исправление платы V02
    [Dash 6.8.kicad_pcb, Dash 6.8.kicad_sch]
2025-10-01 enclosure fix and clarification
    [cover.STEP, cover_v1_1.STEP, frame_v1.STEP]
